ynerpoe/Muon-Detector/Sensor GM Specs/specs_GM_tubes.pdf

https://www.alibaba.com/product-detail/M4011-Glass-Tube-for-Geiger-Counter_1600933371317.html

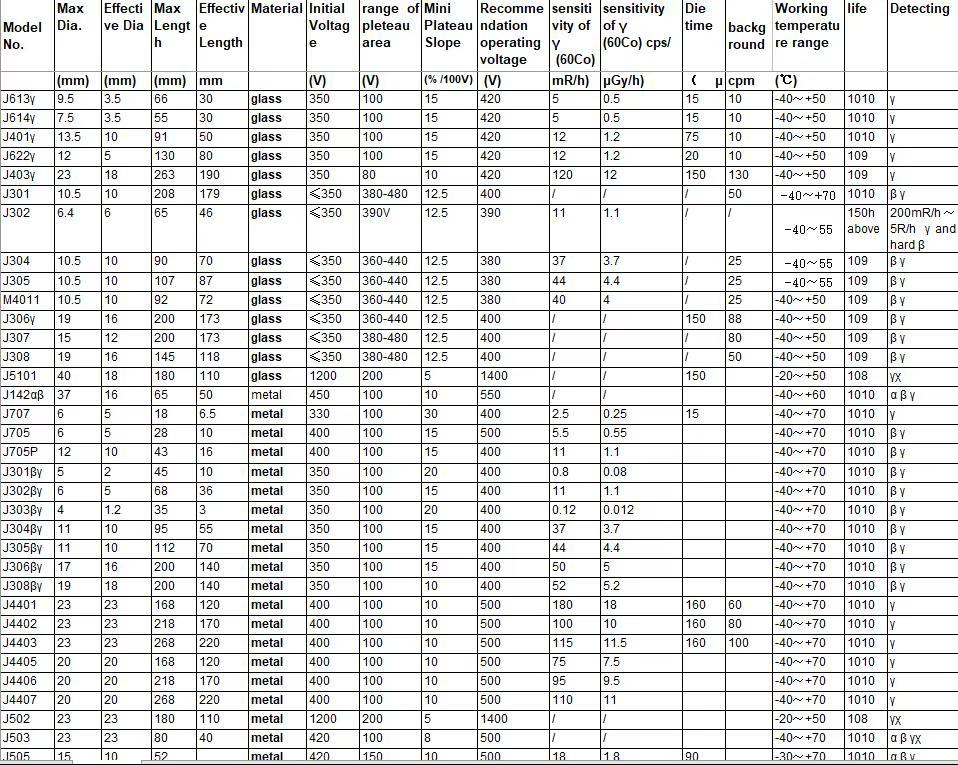
[picture p1: figure]
